ConnyCola/SolderingStation/3D/lotstationtapa.SLDPRT

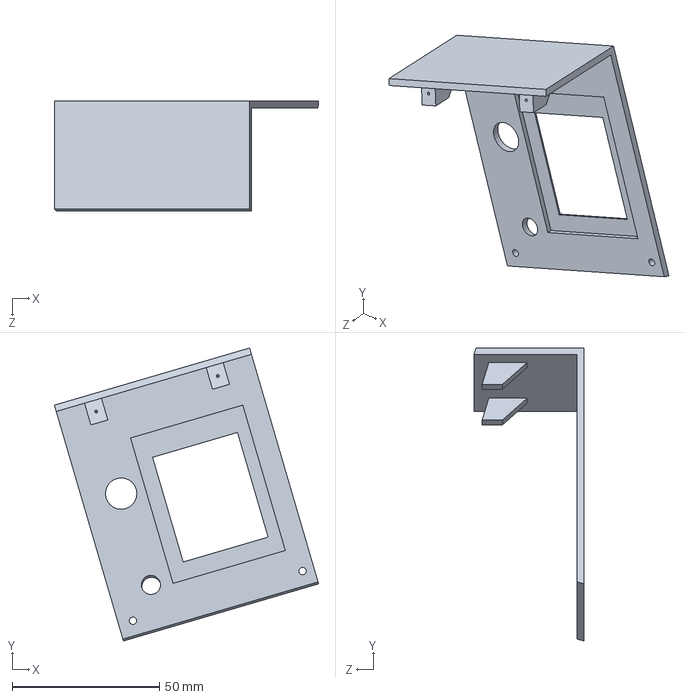
[picture p1: CAD file, 2015-07-20]
3D/lotstationtapa.SLDPRT
89.6 x 99.4 x 37.3 mm
