ConnyCola/SolderingStation/3D/tapon.SLDPRT

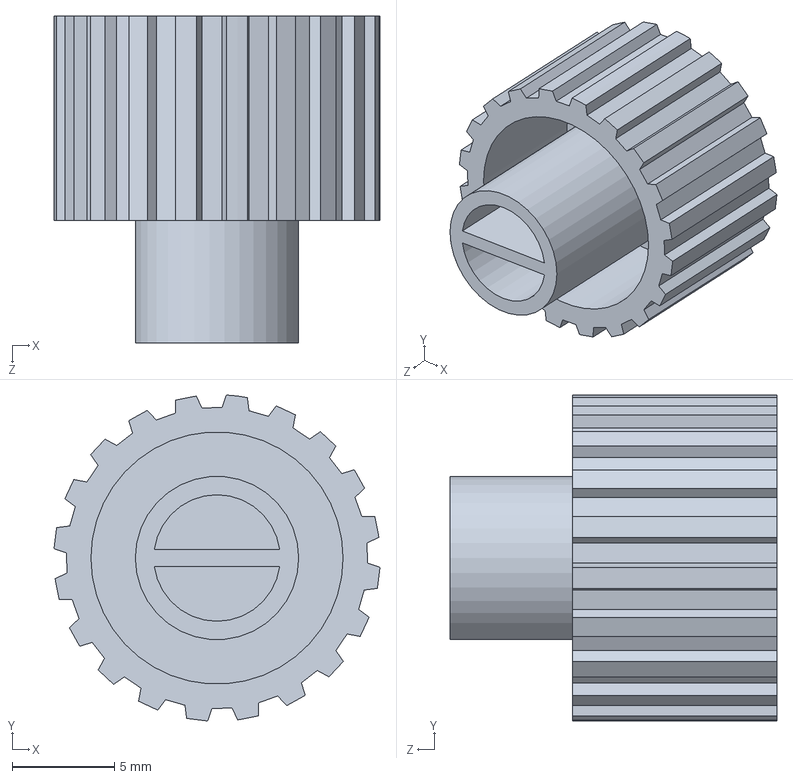
[picture p2: CAD file, 2015-07-20]
3D/tapon.SLDPRT
16.0 x 16.0 x 16.0 mm
