ConnyCola/SolderingStation/3D/lotstationv2.SLDPRT

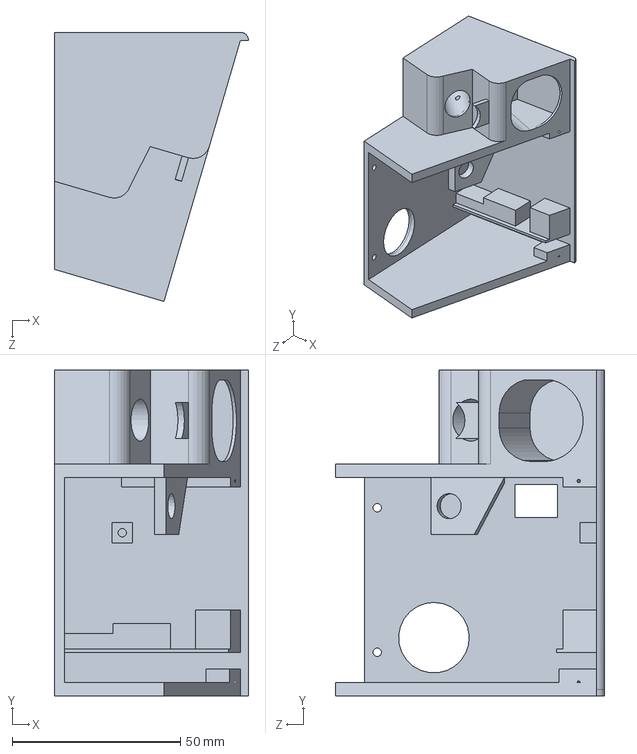
[picture p3: CAD file, 2015-07-20]
3D/lotstationv2.SLDPRT
57.7 x 97.0 x 80.0 mm
