ConnyCola/SolderingStation/(list of files, cad)

Other CAD files:
3D/lotstationtapa.STL
3D/lotstationv2.STL
3D/tapon.STL
