ConnyCola/SolderingStation/eagle/solderstation_v1_6.pdf

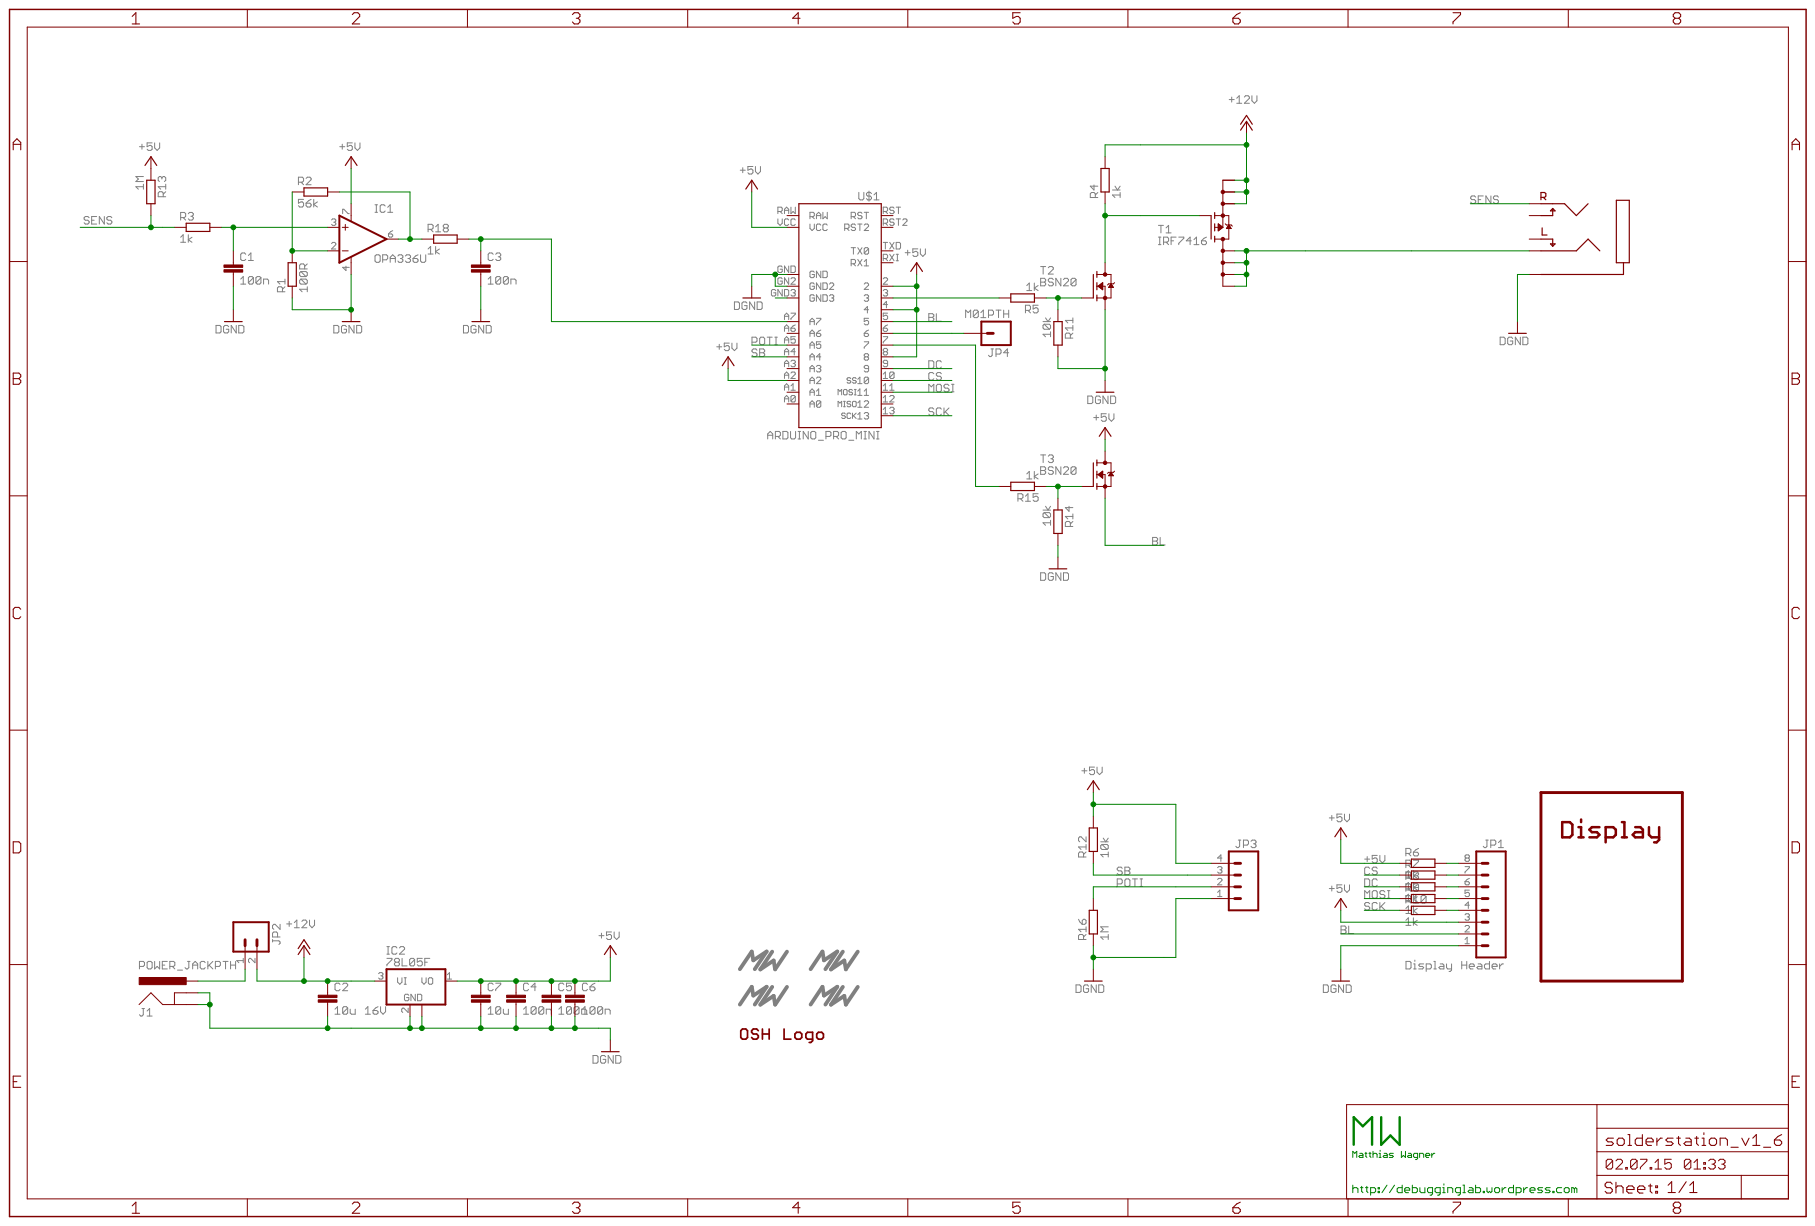
[picture p4: page 1]
