ConnyCola/SolderingStation/eagle/solderstation_v1_6_brd.pdf

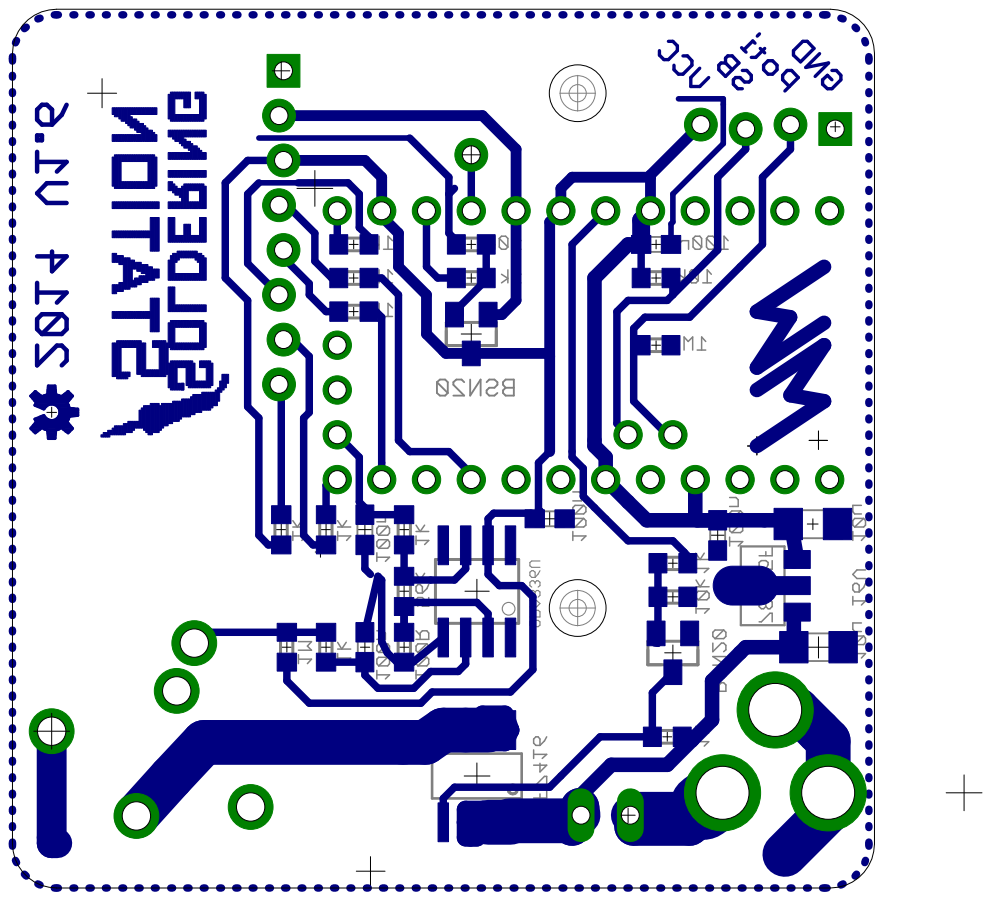
[picture p5: page 1]
