ConnyCola/SolderingStation/eagle/solderstation_v1_6.brd

## EAGLE design eagle/solderstation_v1_6.brd (2015-07-01)

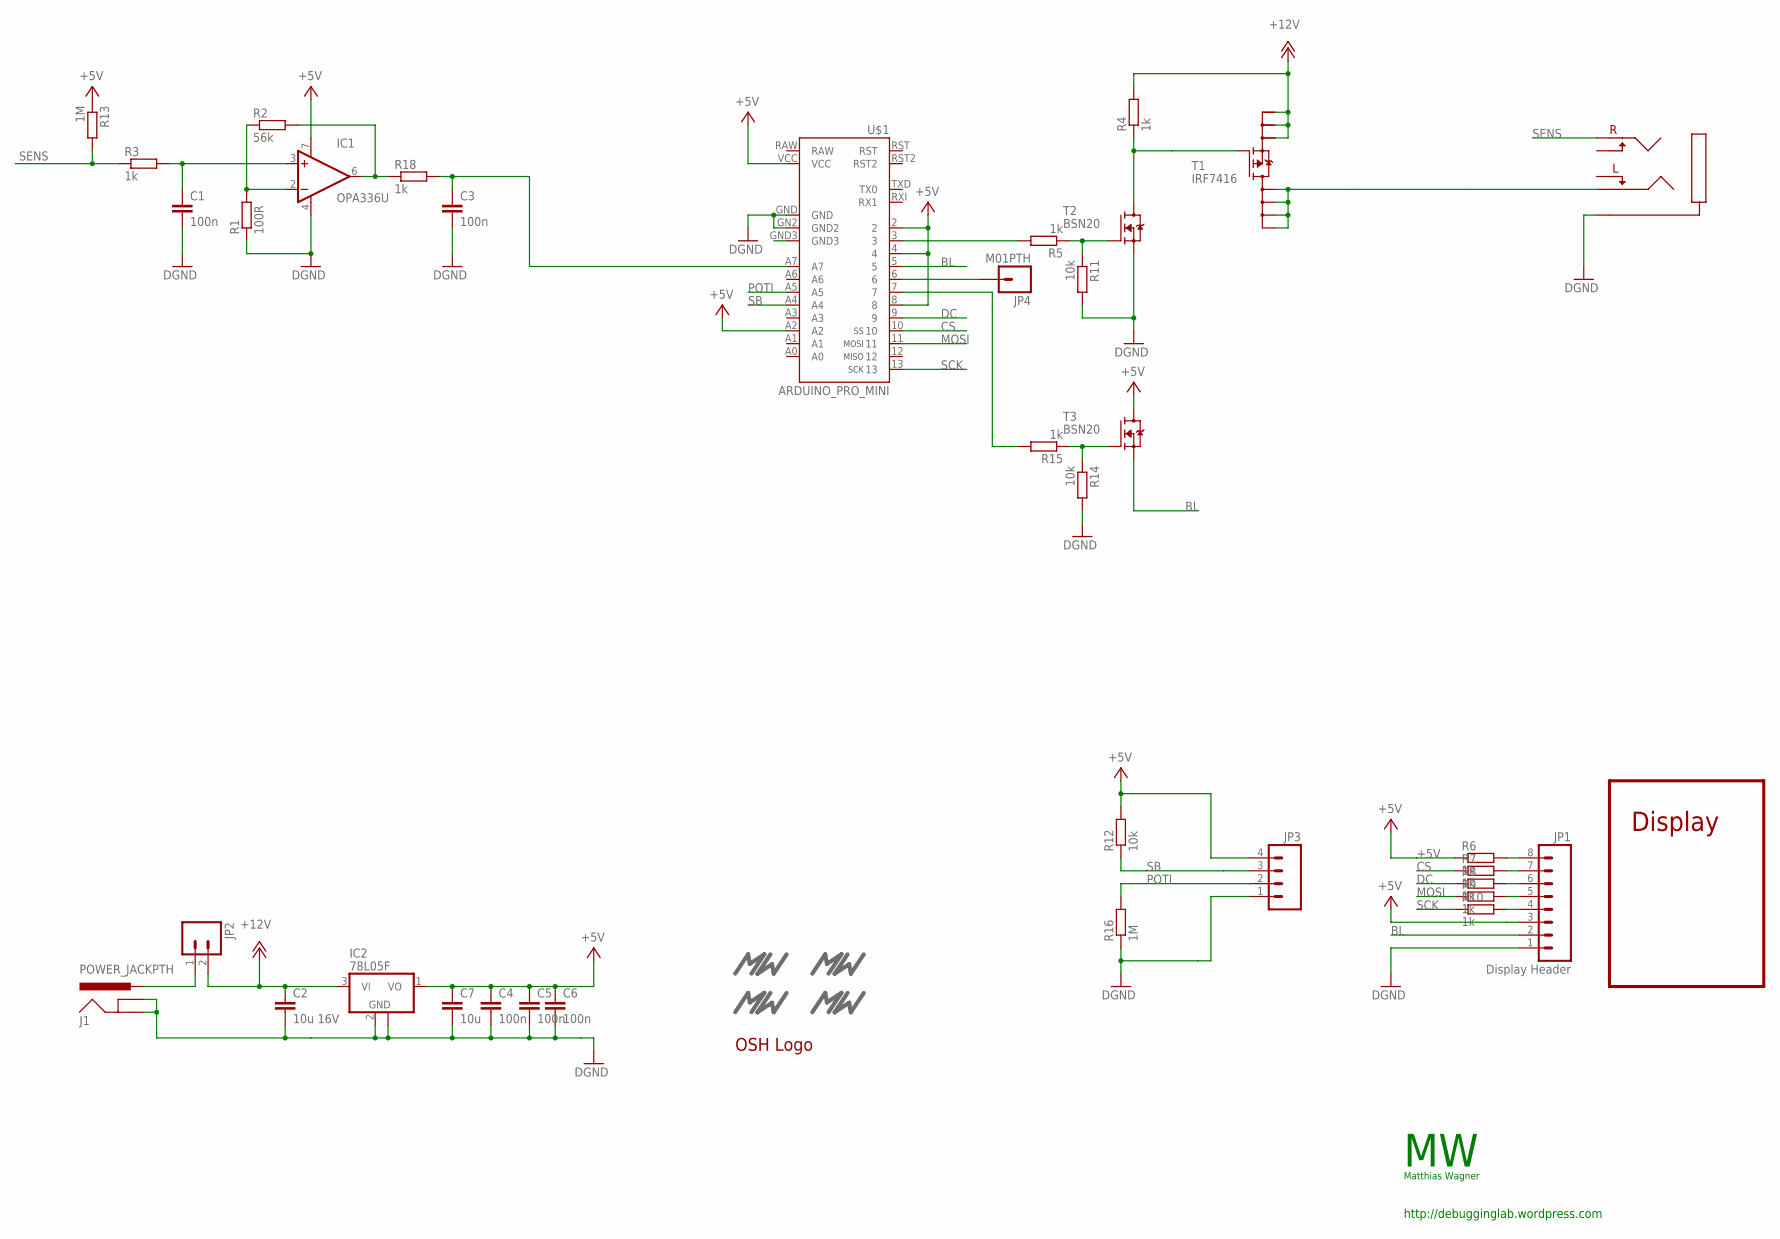
[picture p6: schematic solderstation_v1_6.sch]

Parts:
C1, C3, C4, C5, C6: 100n; C0603
C2: 10u 16V; C1206
C7: 10u; C1206
IC1: OPA336U; SO08
IC2: 78L05F; SOT89
J1: POWER_JACKPTH; POWER_JACK_PTH
JP1: Display Header; 1X08_LOCK
JP2: M02LOCK_LONGPADS; 1X02_LOCK_LONGPADS
JP3: M04LOCK; 1X04_LOCK
JP4: M01PTH; 1X01
R1: 100R; R0603
R2: 56k; R0603
R3, R4, R5, R6, R7, R8, R9, R10, R15, R18: 1k; R0603
R11, R12, R14: 10k; R0603
R13, R16: 1M; R0603
T1: IRF7416; SO8
T2, T3: BSN20; SOT23
U$1: ARDUINO_PRO_MINI
U$2: AUDIO_JACK_3,5MMCONRAD; AUDIO_JACK_3,5MM_CONRAD
U$3, U$5: MW_LOGO; MW_11X5MM
U$4, U$9: MW_LOGO_SOLDER; MW_11X5MM_SOLDER
U$8: OSH_LOGOS; OSH_LOGO_S

Connections:
+5V: C4.1, C5.1, C6.1, C7.1, IC1.7 (V+), IC2.1 (VO), JP1.3, JP3.4, R6.1, R12.2, R13.1, T3.3 (D), U$1.2, U$1.4, U$1.8, U$1.A2, U$1.VCC
+12V: C2.1, IC2.3 (VI), JP2.2, R4.2, T1.1 (S0), T1.2 (S1), T1.3 (S2)
BL: JP1.2, T3.2 (S), U$1.5
CS: R7.1, U$1.10
DC: R8.1, U$1.9
DGND: C1.2, C2.2, C3.2, C4.2, C5.2, C6.2, C7.2, IC1.4 (V-), IC2.2 (GND), IC2.2@1 (GND), J1.GND, J1.GNDBREAK, JP1.1, JP3.1, R1.1, R11.2, R14.2, R16.1, T2.2 (S), U$1.GN2 (GND2), U$1.GND, U$2.P_GND
HEATER: T1.5 (D0), T1.6 (D1), T1.7 (D2), T1.8 (D3), U$2.P_LEFT
MOSI: R9.1, U$1.11
unnamed: IC1.2 (-IN), R1.2, R2.1
unnamed: IC1.6 (OUT), R2.2, R18.1
unnamed: R5.1, R11.1, T2.1 (G)
unnamed: C1.1, IC1.3 (+IN), R3.2
unnamed: R4.1, T1.4 (G), T2.3 (D)
unnamed: JP1.4, R10.2
unnamed: R5.2, U$1.3
unnamed: JP1.5, R9.2
unnamed: JP1.6, R8.2
unnamed: JP1.7, R7.2
unnamed: JP1.8, R6.2
unnamed: J1.PWR, JP2.1
unnamed: R14.1, R15.1, T3.1 (G)
unnamed: R15.2, U$1.7
unnamed: JP4.1, U$1.6
unnamed: C3.1, R18.2, U$1.A7
POTI: JP3.2, R16.2, U$1.A5
SB: JP3.3, R12.1, U$1.A4
SCK: R10.1, U$1.13
SENS: R3.1, R13.2, U$2.P_RIGHT

Notes on the sheet:
Display
http://debugginglab.wordpress.com
Matthias Wagner

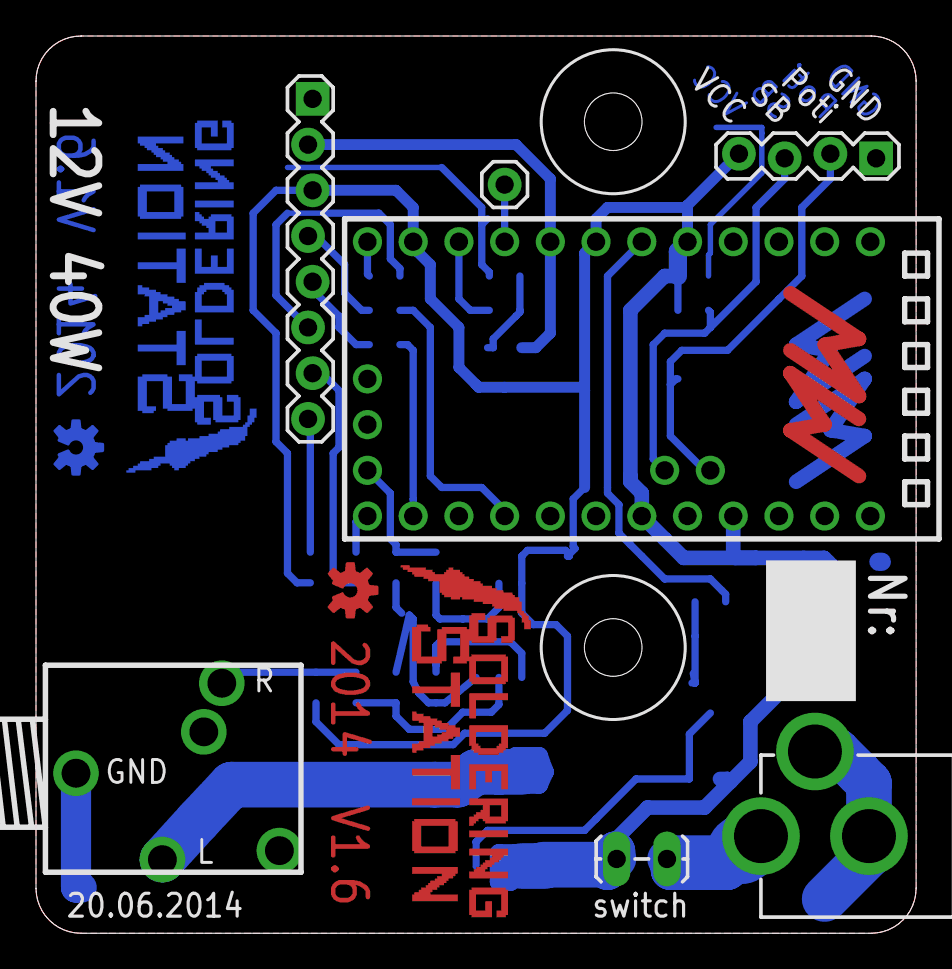
[picture p7: board solderstation_v1_6.brd from above]

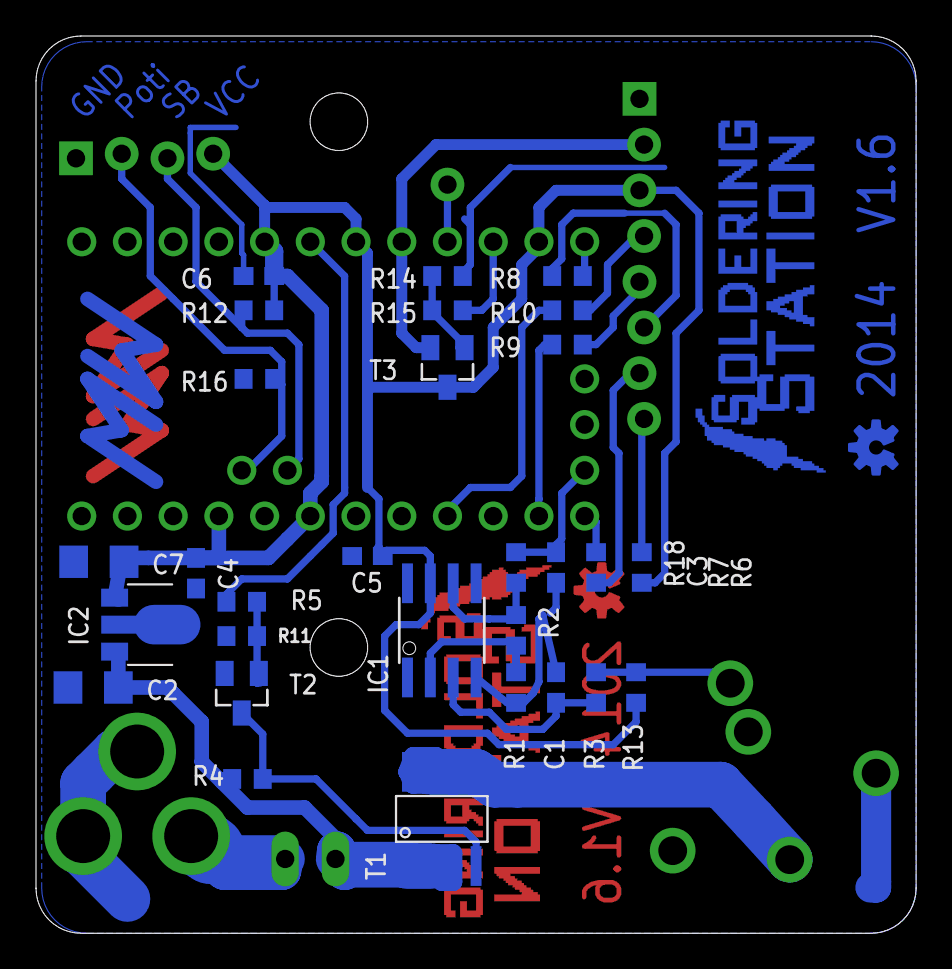
[picture p8: board solderstation_v1_6.brd from below]

Board: 2 copper layers, 48.9 x 49.8 mm, 44 parts (33 on the bottom side), 28 nets.

Other parts of the board:
U$6, U$7: SOLDER_STATION19,5MM_BOT; SOLDER_STATION_19,5MM_BOT
U$10: OSH_LOGOS; OSH_LOGO_S
