ConnyCola/SolderingStation/(threads)

Thread 1 (2015-07-19):

3D printed Case sketches

thorstenweber83, 2015-07-19:
It would be really nice to also have the plans for the 3D printed enclosure!
Maybe you can ask your 3D printing friend to add them to the repo.

thanks in advance
Thorsten

ConnyCola, 2015-07-20:
Hi Thorsten,
I added the 3D files. I don't really know if you can work with this format but I just hope so :)

thorstenweber83, 2015-07-20:
very nice thank you!

Closed 2015-07-20.
