ConnyCola/SolderingStation/(commit log)

2014-10-30 first upload
    [solderstation_v1_6.brd, solderstation_v1_6.sch]
2015-07-01 update with schematic
    [solderstation_v1_6.brd, solderstation_v1_6.sch]
2015-07-01 added BOM
2015-07-01 BOM + StoreName
2015-07-20 new 3D files
    added the 3D files because of lots of questions for it
    [lotstationtapa.SLDPRT, lotstationtapa.STL, lotstationv2.SLDPRT, lotstationv2.STL, tapon.SLDPRT, tapon.STL]
